IEEE-UCF/SEC26Field/README.md

# SEC26Field
Contains the field setup guide for both the Official IEEE SEC 26 setup as well as UCF's own setup.
UCF's own setup will have (TODO: use "mesh" or "wired") network such that Earth and all Beacons are connected to one microcontroller, simplifying the scoring process.
