IEEE-UCF/SEC26Field/doc/print/Sample Table Assembly Fixed.stp

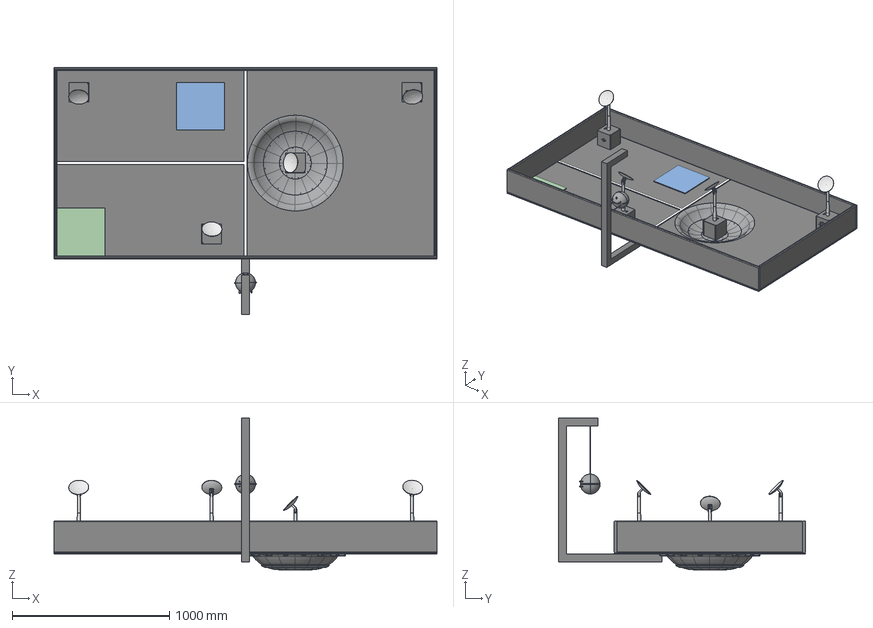
[picture p1: CAD file, 2025-08-19]
doc/print/Sample Table Assembly Fixed.stp
2438.4 x 1574.8 x 965.2 mm
48x96 sheet
8x44 wall x 2
8x96 wall x 2
antenna_box_button
flat_area_v1 x 2
flat_area_v2 x 2
lower_rim x 16
upper_rim x 16
antenna_box_unmodified
antenna_shaft_bottom x 4
antenna_shaft_top x 4
antenna_dish x 4
antenna_box_hatch x 4
Shell_v1
Shell_v2
antenna_box_keypad
antenna_box_crank
