IEEE-UCF/SEC26Field/doc/print/Southeastcon_3dprint_08_19_2025/Antennas/Antenna#1 Button/antenna_box_button2.stl

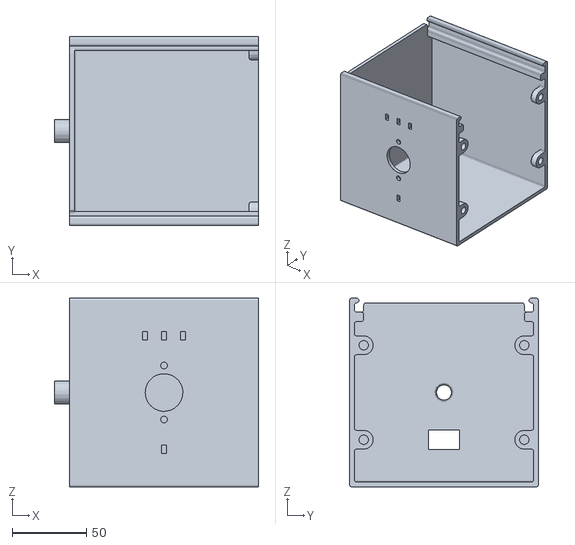
[picture p2: CAD file, 2025-08-21]
doc/print/Southeastcon_3dprint_08_19_2025/Antennas/Antenna#1 Button/antenna_box_button2.stl
137.2 x 127.0 x 127.0
