IEEE-UCF/SEC26Field/doc/print/Southeastcon_3dprint_08_19_2025/Antennas/Antenna#2 Crank/crank_spacers.stl

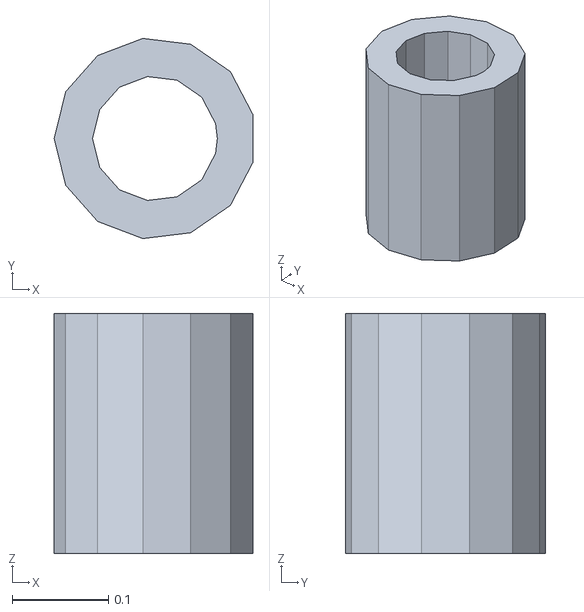
[picture p3: CAD file, 2025-08-19]
doc/print/Southeastcon_3dprint_08_19_2025/Antennas/Antenna#2 Crank/crank_spacers.stl
0.207 x 0.208 x 0.25
