IEEE-UCF/SEC26Field/doc/print/Southeastcon_3dprint_08_19_2025/Antennas/General Antenna/antenna_box_mounting_jig.stl

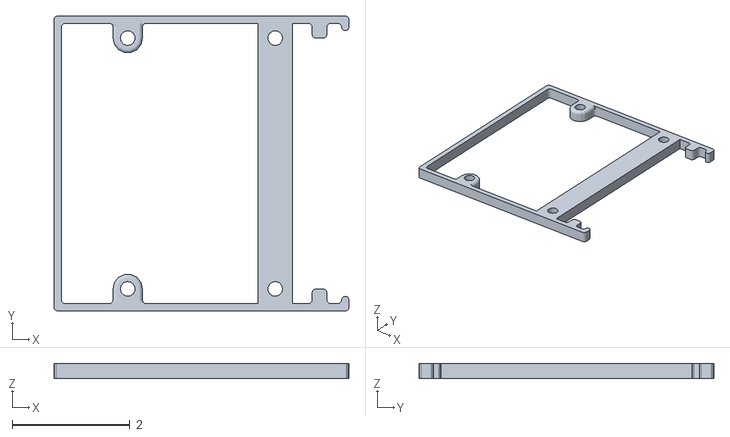
[picture p4: CAD file, 2025-08-19]
doc/print/Southeastcon_3dprint_08_19_2025/Antennas/General Antenna/antenna_box_mounting_jig.stl
5.00 x 5.00 x 0.25
