IEEE-UCF/SEC26Field/doc/print/Southeastcon_3dprint_08_19_2025/Crater/lower_rim.stl

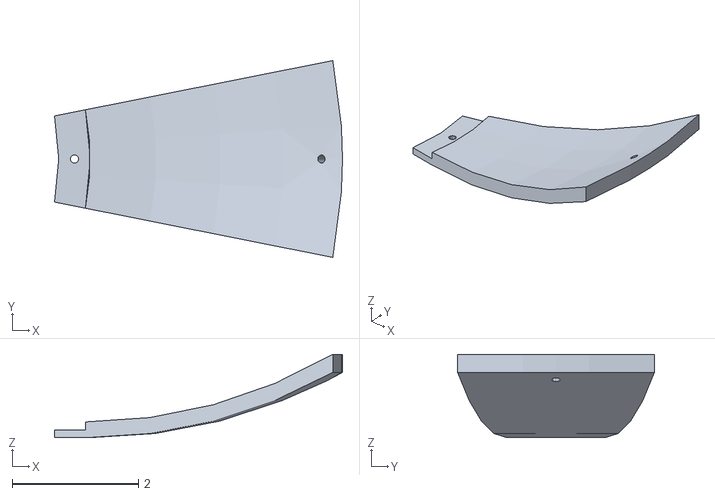
[picture p5: CAD file, 2025-08-19]
doc/print/Southeastcon_3dprint_08_19_2025/Crater/lower_rim.stl
4.57 x 3.12 x 1.32
