IEEE-UCF/SEC26Field/doc/print/Southeastcon_3dprint_08_19_2025/Earth/Shell_v2.stl

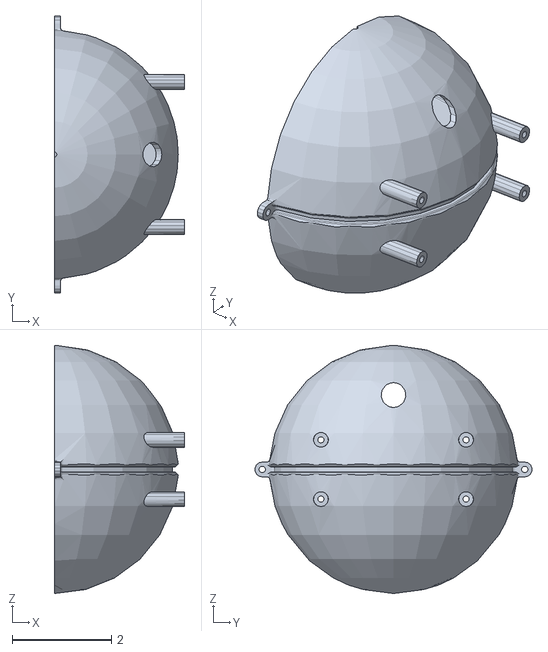
[picture p6: CAD file, 2025-08-19]
doc/print/Southeastcon_3dprint_08_19_2025/Earth/Shell_v2.stl
2.63 x 5.58 x 5.00
