IEEE-UCF/SEC26Field/doc/print/Southeastcon_3dprint_08_19_2025/SouthEastcon2026_Bambu_project.3mf

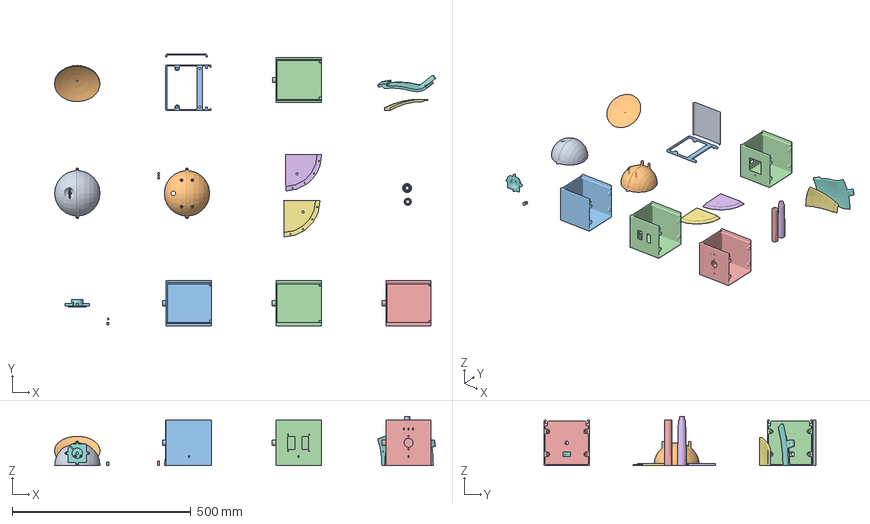
[picture p7: CAD file, 2025-08-21]
doc/print/Southeastcon_3dprint_08_19_2025/SouthEastcon2026_Bambu_project.3mf
1065.6 x 760.3 x 137.2 mm
antenna_box_hatch.stl
antenna_dish.stl
antenna_box_mounting_jig.stl
antenna_box_crank.stl
antenna_shaft_top.stl
antenna_shaft_bottom.stl
lower_rim.stl
upper_rim.stl
Shell_v1.stl
Shell_v2.stl
Hook.stl x 3
flat_area_v1.stl
flat_area_v2.stl
crank_housing.stl
rotary_encoder_sleeve.stl
crank_spacers.stl
antenna_box_pressure.stl
antenna_box_keypad2.stl
antenna_box_button2.stl
