IEEE-UCF/SEC26Field/doc/print/Southeastcon_3dprint_08_19_2025/Antennas/Antenna#2 Crank/crank_housing.stl

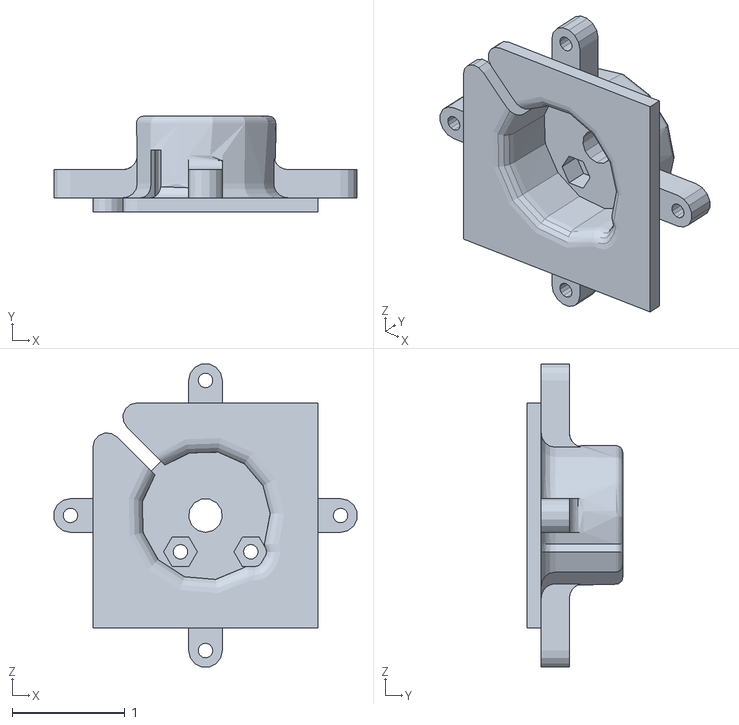
[picture p8: CAD file, 2025-08-19]
doc/print/Southeastcon_3dprint_08_19_2025/Antennas/Antenna#2 Crank/crank_housing.stl
2.69 x 0.85 x 2.69
