IEEE-UCF/SEC26Field/doc/print/Southeastcon_3dprint_08_19_2025/Antennas/General Antenna/antenna_box_hatch.stl

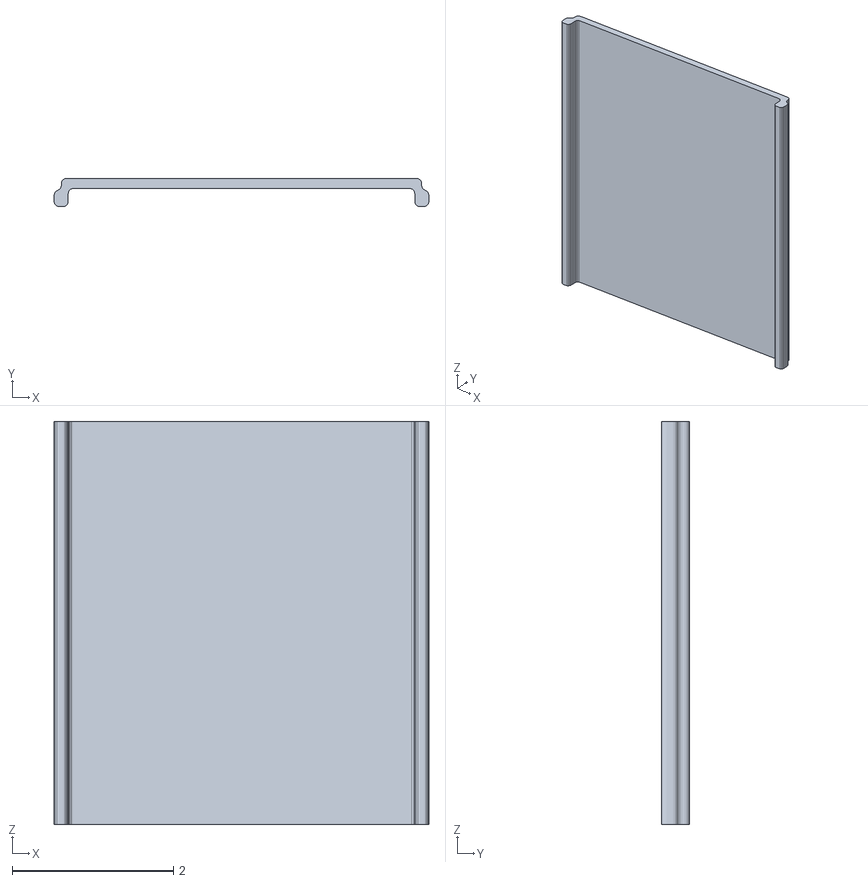
[picture p9: CAD file, 2025-08-19]
doc/print/Southeastcon_3dprint_08_19_2025/Antennas/General Antenna/antenna_box_hatch.stl
4.65 x 0.35 x 5.00
