IEEE-UCF/SEC26Field/doc/print/Southeastcon_3dprint_08_19_2025/Crater/flat_area_v2.stl

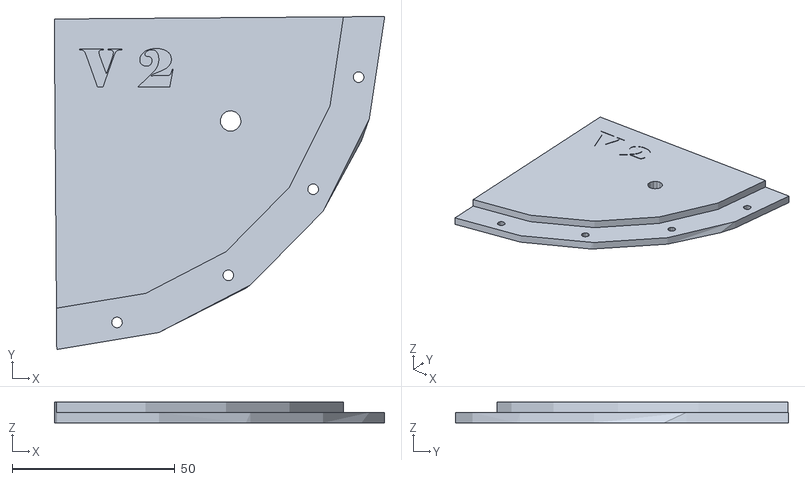
[picture p10: CAD file, 2025-08-19]
doc/print/Southeastcon_3dprint_08_19_2025/Crater/flat_area_v2.stl
101.6 x 102.4 x 6.35
