IEEE-UCF/SEC26Field/doc/print/Southeastcon_3dprint_08_19_2025/Antennas/General Antenna/antenna_shaft_bottom.stl

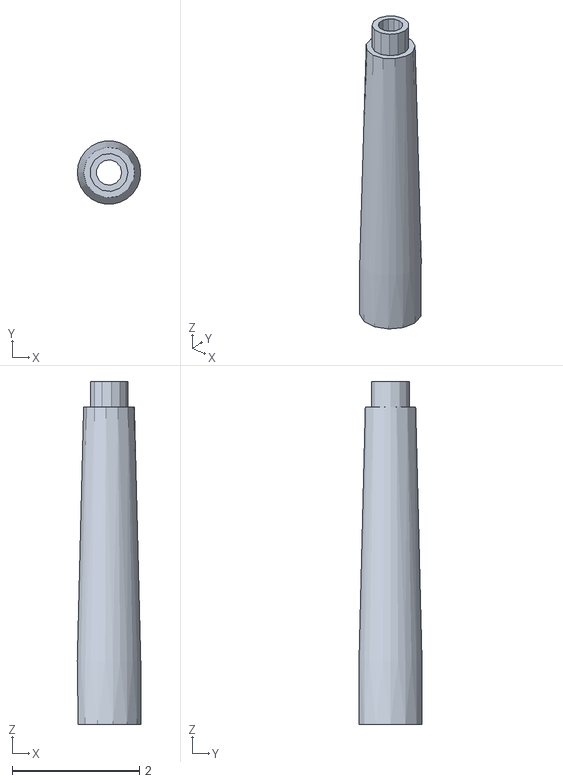
[picture p11: CAD file, 2025-08-19]
doc/print/Southeastcon_3dprint_08_19_2025/Antennas/General Antenna/antenna_shaft_bottom.stl
1.00 x 0.993 x 5.40
