IEEE-UCF/SEC26Field/doc/print/Southeastcon_3dprint_08_19_2025/Crater/upper_rim.stl

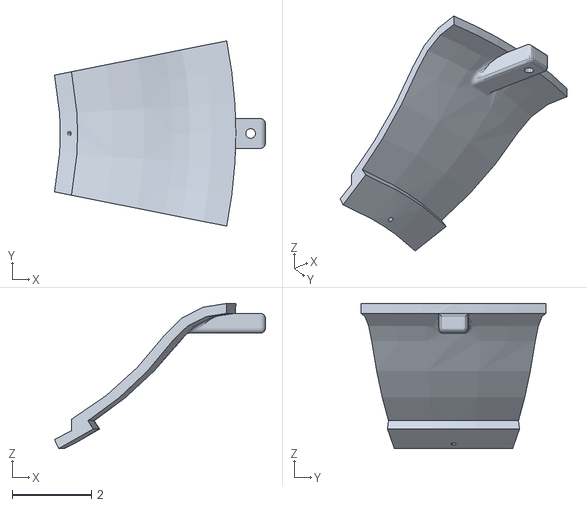
[picture p12: CAD file, 2025-08-19]
doc/print/Southeastcon_3dprint_08_19_2025/Crater/upper_rim.stl
5.33 x 4.68 x 3.67
