IEEE-UCF/SEC26Field/doc/print/Southeastcon_3dprint_08_19_2025/Antennas/Antenna#2 Crank/rotary_encoder_sleeve.stl

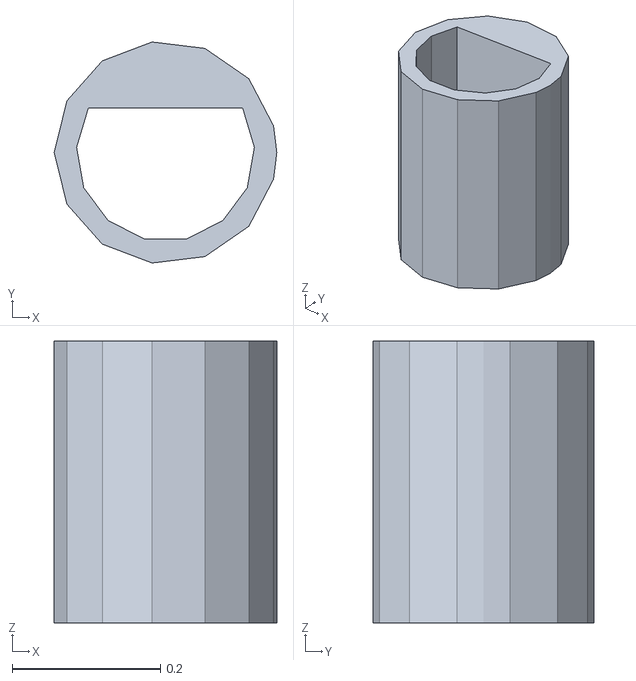
[picture p13: CAD file, 2025-08-19]
doc/print/Southeastcon_3dprint_08_19_2025/Antennas/Antenna#2 Crank/rotary_encoder_sleeve.stl
0.3 x 0.298 x 0.38
