IEEE-UCF/SEC26Field/doc/print/Southeastcon_3dprint_08_19_2025/Antennas/General Antenna/antenna_dish.stl

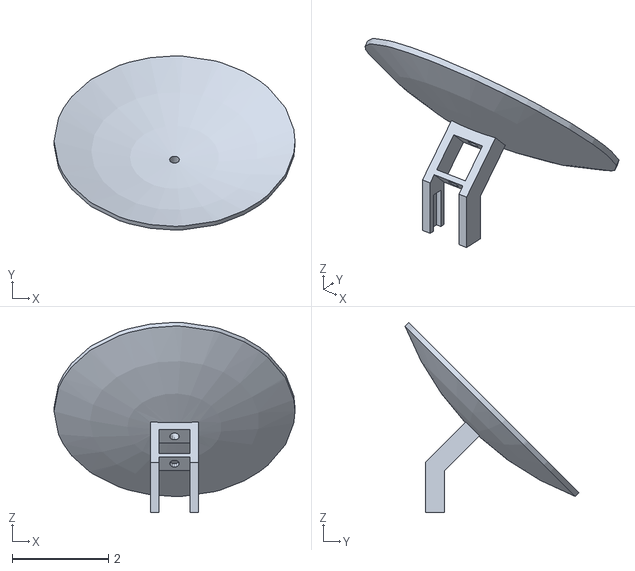
[picture p14: CAD file, 2025-08-19]
doc/print/Southeastcon_3dprint_08_19_2025/Antennas/General Antenna/antenna_dish.stl
5.00 x 3.61 x 3.95
