IEEE-UCF/SEC26Field/doc/print/Southeastcon_3dprint_08_19_2025/Antennas/General Antenna/antenna_shaft_top.stl

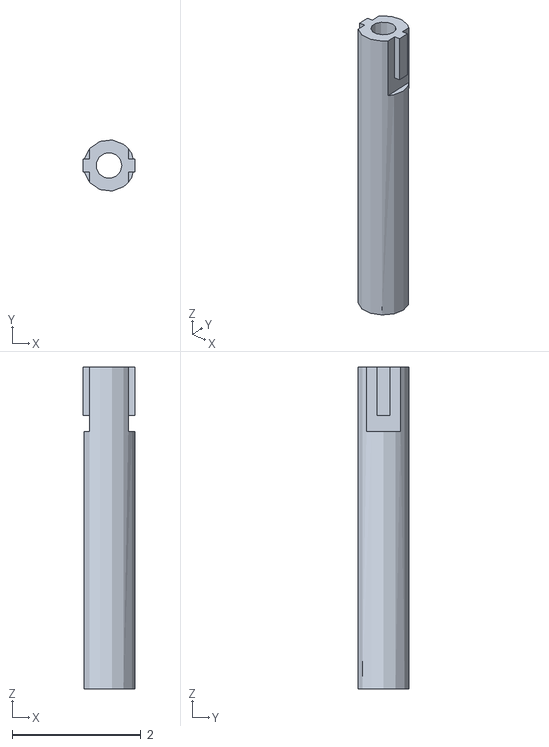
[picture p15: CAD file, 2025-08-19]
doc/print/Southeastcon_3dprint_08_19_2025/Antennas/General Antenna/antenna_shaft_top.stl
0.8 x 0.794 x 5.00
