IEEE-UCF/SEC26Field/(list of files, cad)

Other CAD files:
doc/print/Southeastcon_3dprint_08_19_2025/Antennas/Antenna#3 Pressure/antenna_box_pressure.stl
doc/print/Southeastcon_3dprint_08_19_2025/Antennas/Antenna#4 Key Pad/antenna_box_keypad2.stl
doc/print/Southeastcon_3dprint_6_20_2025/Antennas/Antenna#1 Button/antenna_box_button.stl
doc/print/Southeastcon_3dprint_6_20_2025/Antennas/Antenna#4 Key Pad/antenna_box_keypad.stl
doc/print/Southeastcon_3dprint_08_19_2025/Antennas/Antenna#2 Crank/antenna_box_crank.stl
doc/print/Southeastcon_3dprint_08_19_2025/Crater/flat_area_v1.stl
doc/print/Southeastcon_3dprint_08_19_2025/Earth/Shell_v1.stl
