IEEE-UCF/SEC26Field/(commit log)

2025-08-19 add: official SEC
    [Sample Table Assembly Fixed.stp, Shell_v1.stl, Shell_v2.stl, SouthEastcon2026_Bambu_project.3mf, antenna_box_button.stl, antenna_box_crank.stl, antenna_box_hatch.stl, antenna_box_keypad.stl]
2025-08-19 add: button program
2025-08-19 add: state switch, sensor
2025-08-20 button change
2025-08-20 Earthpad 'fix', nothing needed to be changed much
    [Earth_Receive_Code_Final.ino]
2025-08-20 keypad ESP32 fix
2025-08-20 sensor done!
2025-08-21 add: new 3dp
    [Shell_v1.stl, Shell_v2.stl, SouthEastcon2026_Bambu_project.3mf, antenna_box_button2.stl, antenna_box_crank.stl, antenna_box_hatch.stl, antenna_box_keypad2.stl, antenna_box_mounting_jig.stl]
